bysstandeer/Air-Mouse-Project/Schematic and Circuit Diagram.pdf

Schematic and Circuit Diagram

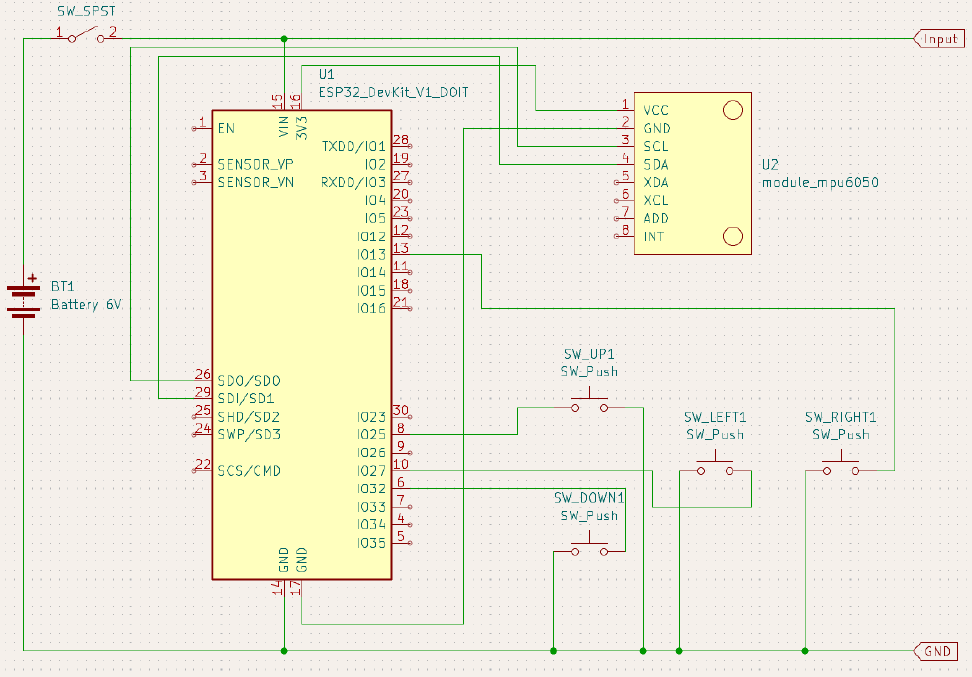
[picture p1: figure]

Figure 1. Schematic Diagram.

PIN CONNECTIONS ON ESP32

COMPONENTS | ESP32 PINS
Left Button | GPIO 27
Right Button | GPIO 13
Scroll Up Button | GPIO 25
Scroll Down Button | GPIO 32
MPU6050 SDA | [SDI/SD1] GPIO 21
MPU6050 SCL | [SDO/SDO] GPIO 22
MPU6050 VCC | 3V3
MPU6050 GND | GND (Beside 3V3)

BATTERY VCC+ | VIN
BATTERY GND- | GND (Beside VIN)
Table 1. List of Pin Connections.

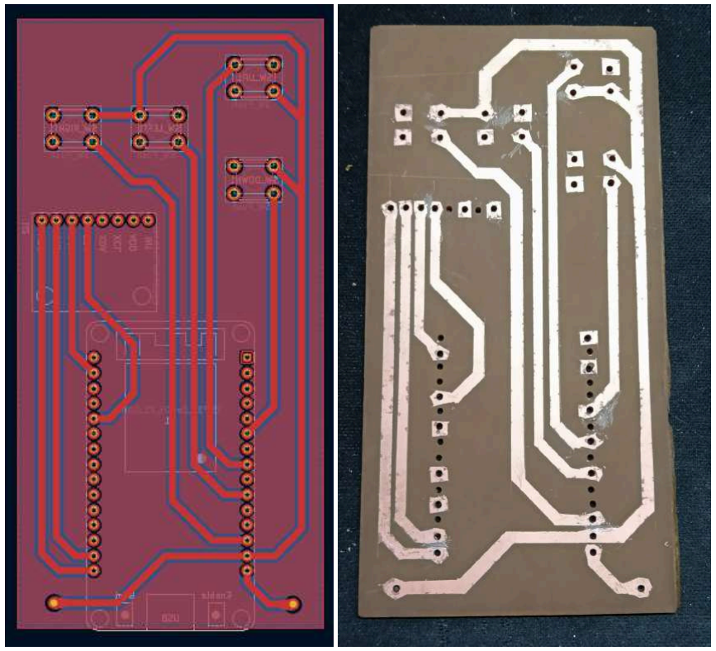
[picture p2: figure]

Figure 2. Routing Circuit of PCB.
