bysstandeer/Air-Mouse-Project/Possible Improvements.pdf

Possible Improvements

1. Additional Features
- Drag
- One of the basic functions of a mouse that this project was not able to meet. The drag function allows users to select multiple items at once and drag them around however they want.
- DPI Adjustment
- With an additional button to automatically adjust the DPI or Dots Per Inch on the sensitivity of the air mouse. Although this can be adjusted manually on the device, an additional feature to the mouse can be a bonus for the user.
2. Case
- The modified plastic pencil case from the local market was able to suffice for this project. However, a better idea for the air mouse case could be a customized 3D printed one, better modification of the material for the air mouse, or any more creative approaches.
