bysstandeer/Air-Mouse-Project/Flowchart.png

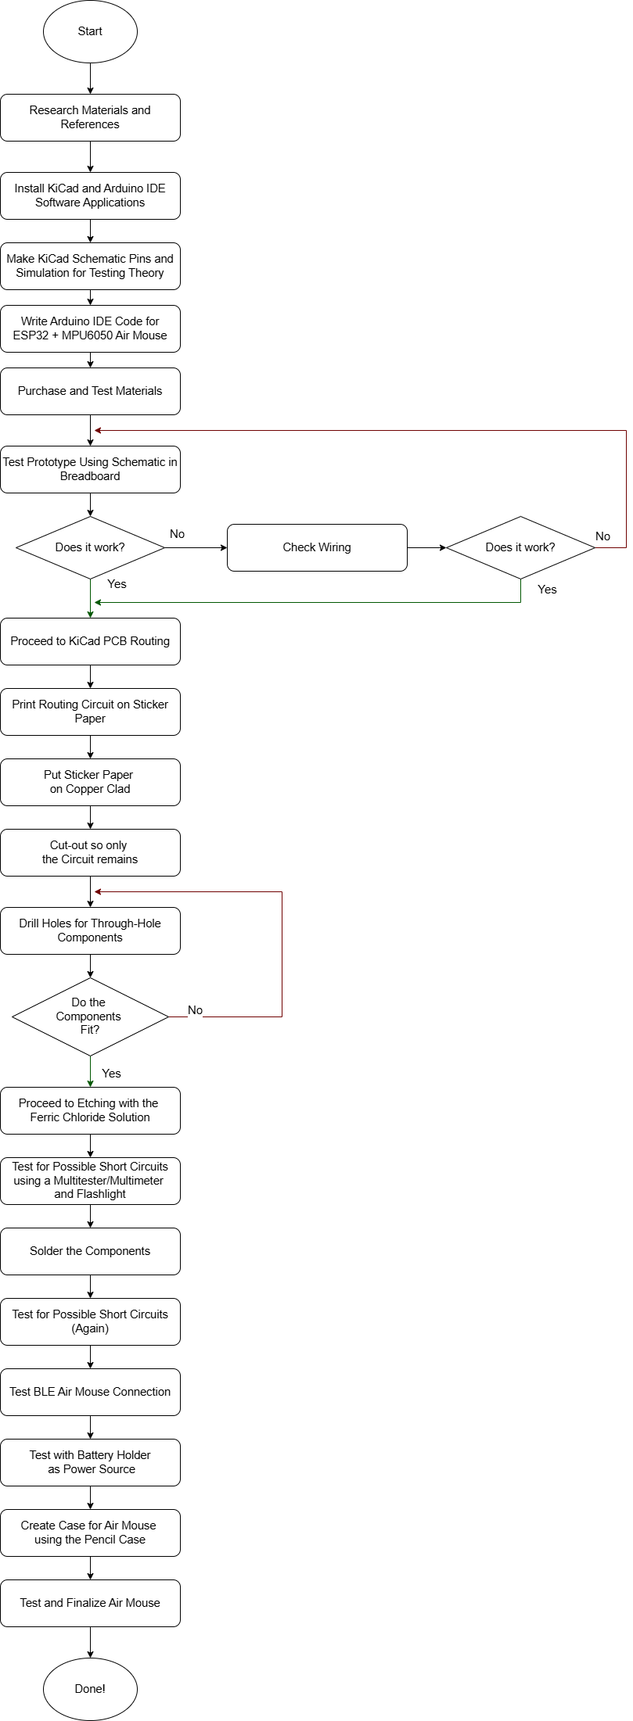
Flowchart.png
