bysstandeer/Air-Mouse-Project/Materials and Tools Used.pdf

Materials and Tools Used

Quantity | Materials | Picture

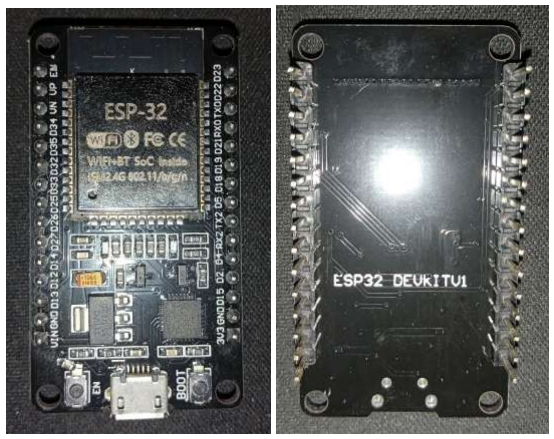
[picture p4: figure]

1 | ESP32 (30-pins)

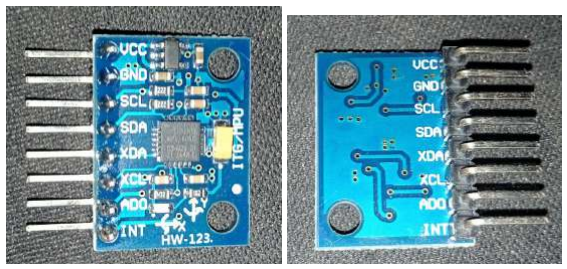
[picture p5: figure]

1 | MPU6050 Gyroscope

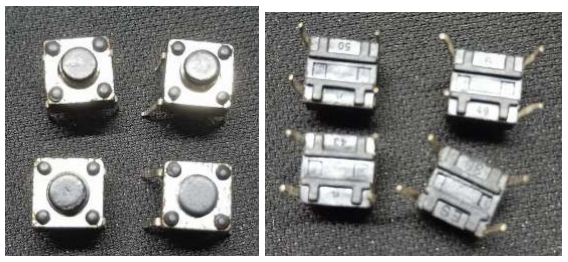
[picture p6: figure]

4 | Push Buttons

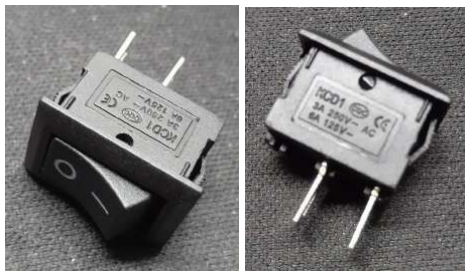
[picture p7: figure]

1 | SPST (Rocker) Switch

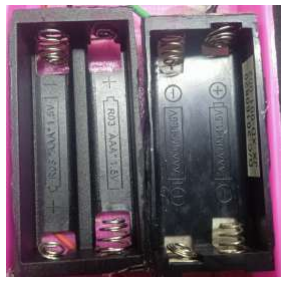
[picture p8: figure]

1 | AAA Battery Holder

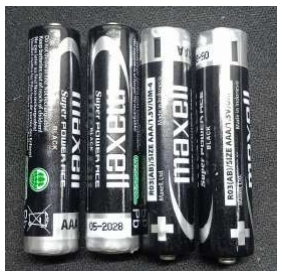
[picture p9: figure]

4 | AAA Batteries
2 | Solder Pins

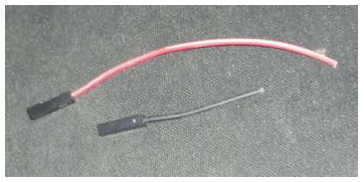
[picture p10: figure]

2 | Female Connector (For Batter Holder)

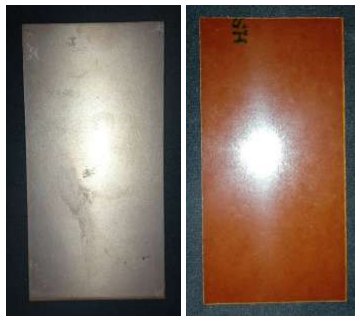
[picture p11: figure]

1 | Copper Clad (2x4)

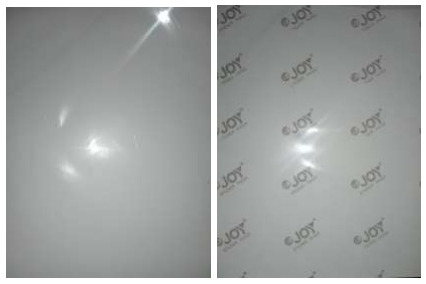
[picture p12: figure]

1 | Sticker Paper

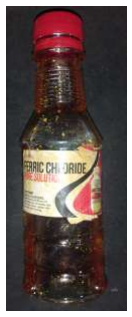
[picture p13: figure]

1 | Ferric Chloride (For Etching)

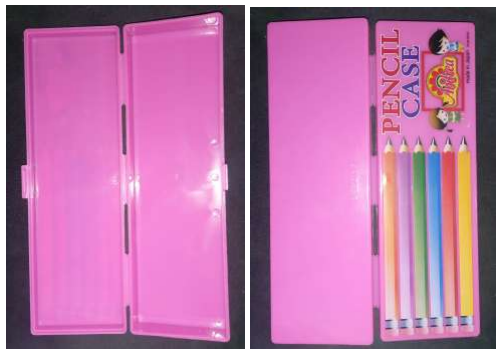
[picture p14: figure]

1 | Pencil Case

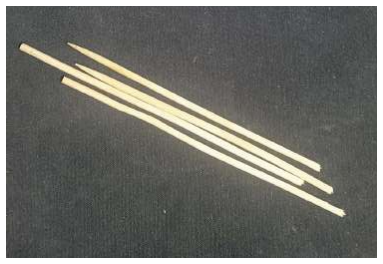
[picture p15: figure]

2 | Barbecue Sticks

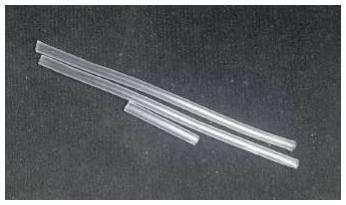
[picture p16: figure]

2 | Plastic Straws

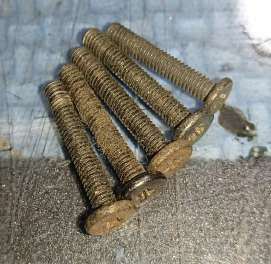
[picture p17: figure]

5 | Screws

1 | Button (Reused from Old Remote Control)

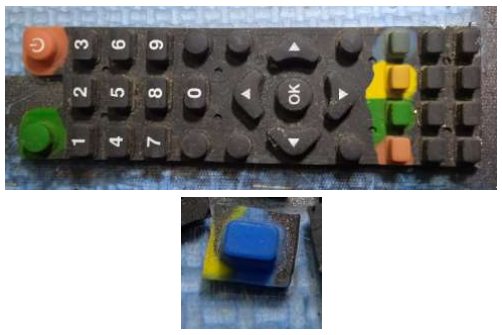
[picture p18: figure]

Quantity | Tools
1 | Scissors
1 | Cutter
1 | Tweezers
1 | Electric Drill/Saw
1 | Plastic Container (For Ferric Chloride)
1 | Soldering Iron
1 | Soldering Lead
1 | Soldering Flux
1 | Double-Sided Tape
1 | Masking Tape
1 | Glue Gun
2 | Glue Stick
1 | Tape (For Covering the Case)
